chickadee-tech/pygb/README.md

# pygb
A Python powered GameBoy-compatible cartridge with a SAMD51

The PCB must be 0.8mm thick to fit in an existing game cart. Prototypes are done with OSH Park's 2 oz 0.8mm stackup.
