chickadee-tech/pygb/pygameboy.kicad_pcb

## KiCad design pygameboy.kicad_pcb (2019-03-31)

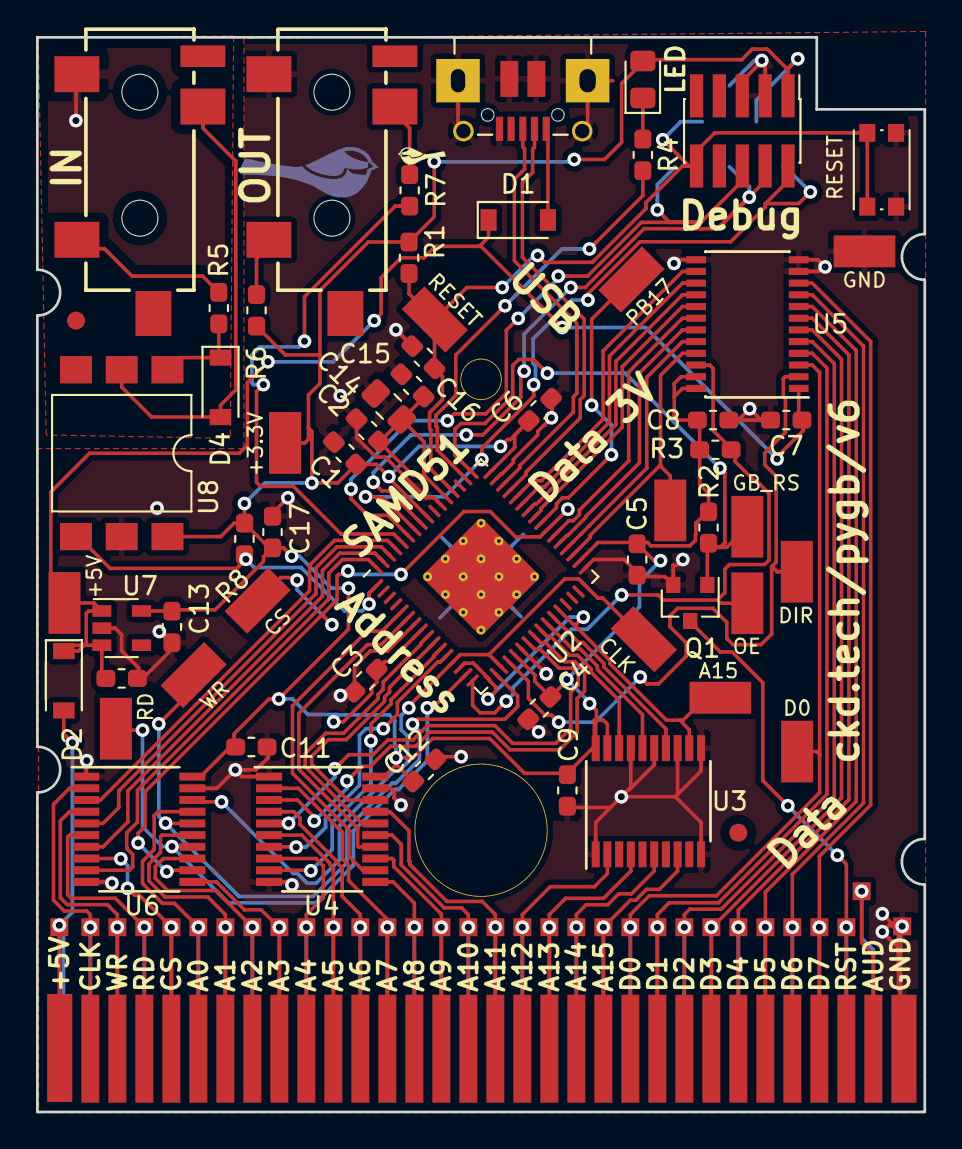
[picture p1: board pygameboy.kicad_pcb from above]

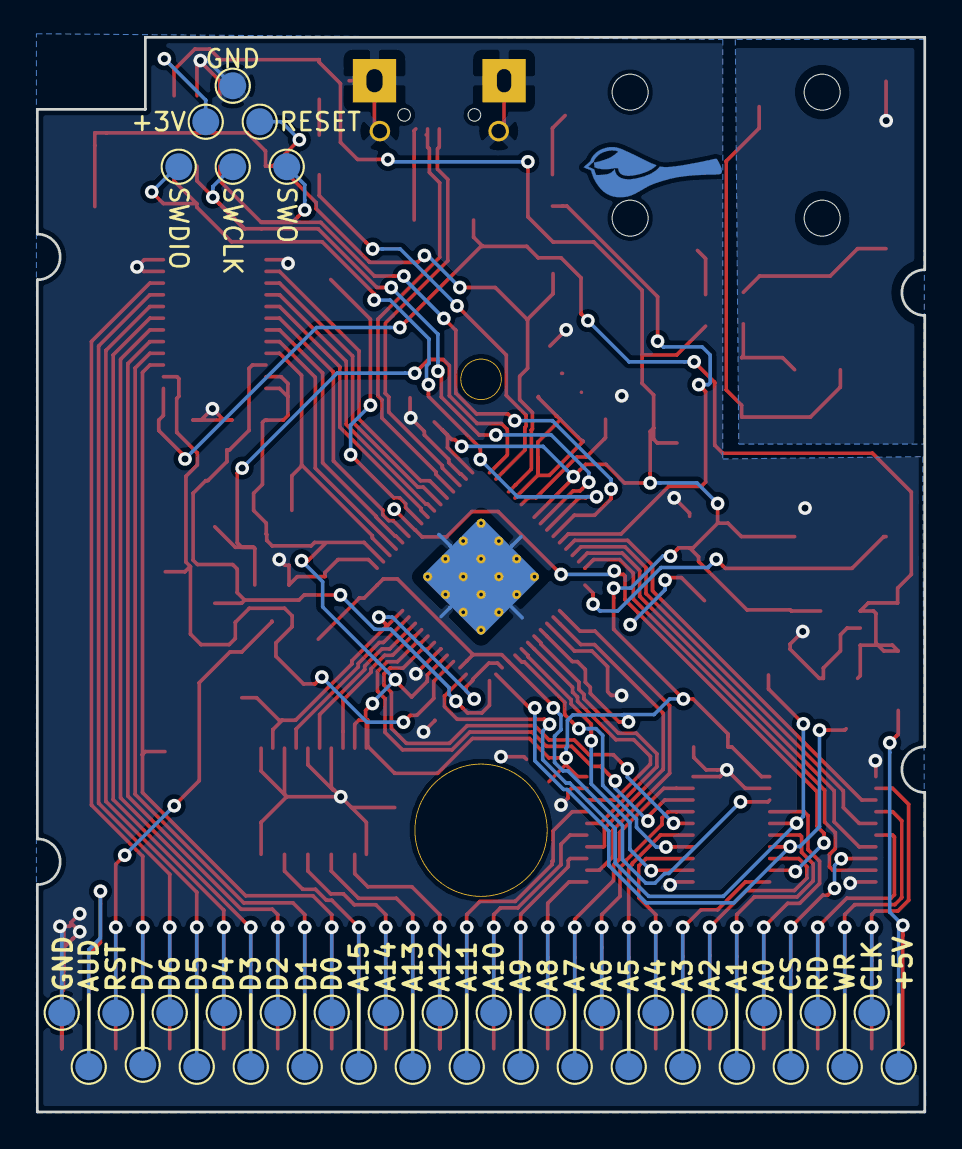
[picture p2: board pygameboy.kicad_pcb from below]

Board: 2 copper layers, 49.3 x 59.7 mm, 132 parts (38 on the bottom side), 83 nets.

Parts:
C1, C2, C3, C4, C5, C6, C7, C8, C9, C11, C12: 0.1uF; C_0603_1608Metric_Pad1.05x0.95mm_HandSolder
C10, C13, C15: 1uF; C_0603_1608Metric_Pad1.05x0.95mm_HandSolder
C14: 10uF; C_0805_2012Metric_Pad1.15x1.40mm_HandSolder
C16, C17: C_Small; C_0603_1608Metric_Pad1.05x0.95mm_HandSolder
D1, D2: MBR120; D_SOD-123
D3: LED; LED_0805_2012Metric_Pad1.15x1.40mm_HandSolder
D4: 1N4148W; D_SOD-123
FID0, FID1: TestPoint; Fiducial_1mm_Mask2mm
J1: Conn_01x01; Small Hole
J2: Conn_01x01; Large Hole
J3: Conn_ARM_JTAG_SWD_10; Pin_Header_Straight_2x05_Pitch1.27mm_SMD
J4: USB_B_Micro; 4UCONN_20329_V2_USB
J5: MIDI IN; 4UCONN_19269_TRS
J6: MIDI OUT; 4UCONN_19269_TRS
Q1: BSS138; SOT-23
R1, R2, R3: 10k; R_0603_1608Metric_Pad1.05x0.95mm_HandSolder
R4: 1k; R_0603_1608Metric_Pad1.05x0.95mm_HandSolder
R5: 220; R_0603_1608Metric_Pad1.05x0.95mm_HandSolder
R6, R7: 51; R_0603_1608Metric_Pad1.05x0.95mm_HandSolder
R8: 470; R_0603_1608Metric_Pad1.05x0.95mm_HandSolder
SW1: SW_Push; SW_SPST_KMR2
TP1, TP2, TP3, TP4, TP5, TP6, TP7, TP8, TP9, TP10, TP11, TP12, TP13, TP14, TP15, TP16, TP17, TP18, TP19, TP20, TP21, TP22, TP23, TP24, TP25, TP26, TP27, TP28, TP29, TP30, TP31, TP32: Test_Point; Test Point
TP33: Test_Point; 5015-SMT-TestPoint-NoPaste
TP34: DATA_OE; 5015-SMT-TestPoint-NoPaste
TP35: GB_RESET; 5015-SMT-TestPoint-NoPaste
TP36: SAMD_RESET; 5015-SMT-TestPoint-NoPaste
TP37: gnd; 5015-SMT-TestPoint-NoPaste
TP38: 3.3v; 5015-SMT-TestPoint-NoPaste
TP39: batt; 5015-SMT-TestPoint-NoPaste
TP40: clk; 5015-SMT-TestPoint-NoPaste
TP41: rd; 5015-SMT-TestPoint-NoPaste
TP42: wr; 5015-SMT-TestPoint-NoPaste
TP43: a15; 5015-SMT-TestPoint-NoPaste
TP44: PB17; 5015-SMT-TestPoint-NoPaste
TP45: cs; 5015-SMT-TestPoint-NoPaste
TP46: data0; 5015-SMT-TestPoint-NoPaste
TP47: D0; 5015-SMT-TestPoint-NoPaste
TP48, TP49, TP50, TP51, TP52, TP53, TP54, TP55, TP56, TP57, TP58, TP59, TP60, TP61, TP62, TP63, TP64, TP65, TP66, TP67, TP68, TP69, TP70, TP71, TP72, TP73, TP74, TP75, TP76, TP77, TP78, TP79, TP80, TP81, TP82, TP83, TP84, TP85: Test_Point; TestPoint_Pad_D1.5mm
U1: CARTRIDGE; Cartridge
U2: SAMD51J; QFN-64-1EP_9x9mm_P0.5mm_EP4.7x4.7mm_ThermalVias
U3, U4, U6: 74LVC244; TSSOP-20_4.4x6.5mm_P0.65mm
U5: 74x4245; TSSOP-24_4.4x7.8mm_P0.65mm
U7: AP2204K-3.3; SOT-23-5
U8: H11L1; SMDIP-6_W9.53mm

Connections:
+3V3: C1.2, C3.2, C4.2, C5.2, C6.2, C8.1, C9.1, C11.1, C12.1, C13.2, C17.1, D3.2, J3.1, R1.1, R2.1, R3.1, R6.1, R8.1, TP38.1, TP84.1, U2.8, U2.21, U2.34, U2.48, U2.56, U3.19, U3.20, U4.20, U5.23, U5.24, U6.20, U7.5, U8.6
+5V: C7.1, C10.2, D1.1, D2.1, TP39.1, U5.1, U7.1, U7.3
+BATT: D2.2, TP1.1, TP48.1, U1.1
/3V_A0: U2.61, U6.3
/3V_A1: U2.62, U6.5
/3V_A2: U2.63, U6.7
/3V_A3: U2.64, U6.9
/3V_A4: U2.5, U4.12
/3V_A5: U2.6, U4.14
/3V_A6: U2.9, U4.16
/3V_A7: U2.10, U4.18
/3V_A8: U2.11, U4.9
/3V_A9: U2.12, U4.7
/3V_A10: U2.23, U4.5
/3V_A11: U2.24, U4.3
/3V_A12: U2.25, U3.18
/3V_A13: U2.26, U3.16
/3V_A14: U2.27, U3.14
/3V_A15: TP43.1, U2.14, U2.17, U2.28, U3.12
/3V_CLK: TP40.1, U2.13, U2.19, U2.32, U6.18
/3V_CS: TP45.1, U2.39, U6.12
/3V_D0: TP46.1, U2.35, U5.21
/3V_D1: U2.36, U5.20
/3V_D2: U2.37, U5.19
/3V_D3: U2.38, U5.18
/3V_D4: U2.41, U5.17
/3V_D5: U2.42, U5.16
/3V_D6: U2.43, U5.15
/3V_D7: U2.44, U5.14
/3V_RD: TP41.1, U2.15, U6.14
/3V_WR: TP42.1, U2.18, U6.16
/A0: TP6.1, TP53.1, U1.6, U6.17
/A1: TP7.1, TP54.1, U1.7, U6.15
/A2: TP8.1, TP55.1, U1.8, U6.13
/A3: TP9.1, TP56.1, U1.9, U6.11
/A4: TP10.1, TP57.1, U1.10, U4.8
/A5: TP11.1, TP58.1, U1.11, U4.6
/A6: TP12.1, TP59.1, U1.12, U4.4
/A7: TP13.1, TP60.1, U1.13, U4.2
/A8: TP14.1, TP61.1, U1.14, U4.11
/A9: TP15.1, TP62.1, U1.15, U4.13
/A10: TP16.1, TP63.1, U1.16, U4.15
/A11: TP17.1, TP64.1, U1.17, U4.17
/A12: TP18.1, TP65.1, U1.18, U3.2
/A13: TP19.1, TP66.1, U1.19, U3.4
/A14: TP20.1, TP67.1, U1.20, U3.6
/A15: TP21.1, TP68.1, U1.21, U3.8
/AUD: TP31.1, TP78.1, U1.31
/CLK: TP2.1, TP49.1, U1.2, U6.2
/CS: TP5.1, TP52.1, U1.5, U6.8
/D0: TP22.1, TP47.1, TP69.1, U1.22, U5.3
/D1: TP23.1, TP70.1, U1.23, U5.4
/D2: TP24.1, TP71.1, U1.24, U5.5
/D3: TP25.1, TP72.1, U1.25, U5.6
/D4: TP26.1, TP73.1, U1.26, U5.7
/D5: TP27.1, TP74.1, U1.27, U5.8
/D6: TP28.1, TP75.1, U1.28, U5.9
/D7: TP29.1, TP76.1, U1.29, U5.10
/DATA_OE: R3.2, TP34.1, U2.16, U5.22
/DIR: TP33.1, U2.20, U5.2
/GB_RESET: Q1.1, R2.2, TP35.1, U2.49
/LED: R4.2, U2.50
/MIDI_IN: R8.2, U2.1, U8.4
/MIDI_OUT: R7.1, U2.60
/RD: TP4.1, TP51.1, U1.4, U6.6
/RESET: Q1.3, TP30.1, TP77.1, U1.30
/SAMD_RESET: C16.1, J3.10, R1.2, SW1.1, TP36.1, TP80.1, U2.52
/SWCLK: J3.4, TP81.1, U2.57
/SWDIO: J3.2, TP82.1, U2.58
/SWO: J3.6, TP83.1, U2.59
/USB_D+: J4.3, U2.46
/USB_D-: J4.2, U2.45
/WR: TP3.1, TP50.1, U1.3, U6.4
GND: C1.1, C2.2, C3.1, C4.1, C5.1, C6.1, C7.2, C8.2, C9.2, C10.1, C11.2, C12.2, C13.1, C14.1, C15.1, C16.2, C17.2, J3.3, J3.5, J4.5, J4.6, J6.S, Q1.2, SW1.2, TP32.1, TP37.1, TP79.1, TP85.1, U1.32, U2.7, U2.22, U2.33, U2.47, U2.54, U2.65, U3.1, U3.10, U3.11, U3.13, U3.15, U3.17, U4.1, U4.10, U4.19, U5.11, U5.12, U5.13, U6.1, U6.10, U6.19, U7.2, U8.5
unnamed: C2.1, C14.2, C15.2, U2.53
unnamed: D3.1, R4.1
unnamed: D4.1, R5.1, U8.1
unnamed: D4.2, J5.R, U8.2
unnamed: J5.T, R5.2
unnamed: J6.R, R7.2
unnamed: J6.T, R6.2
unnamed: TP44.1, U2.40
VBUS: D1.2, J4.1
