chickadee-tech/pygb/(threads)

Thread 6 (2019-10-11):

Making a prototype.

chrisgervang, 2019-10-11:
Hey there! This is a very cool project. I've been interested in gameboy mods this year - rom hacks, pcb mods. I am interested in putting together a prototype of this! Do you have any tips / documentation?

I'm familiar with board bring ups and all the basic stuff.. more curious if there is anything you haven't documented yet that would be helpful.

tannewt, 2019-10-11:
Thanks! I don't have much but am happy to answer questions. The first thing is to get the PCB with 0.8mm rather than the normal 1.6mm. That way it'll fit in existing carts.
