chickadee-tech/pygb/(commit log)

2018-05-02 Initial rev to OSH Park
    [pygameboy-B.Cu.gbr, pygameboy-B.Mask.gbr, pygameboy-B.Paste.gbr, pygameboy-B.SilkS.gbr, pygameboy-Edge.Cuts.gbr, pygameboy-F.Cu.gbr, pygameboy-F.Mask.gbr, pygameboy-F.Paste.gbr]
2018-06-11 v2 with added caps. reworked CCL signals and lotsa test points
    [pygameboy-B.Cu.gbr, pygameboy-B.Mask.gbr, pygameboy-B.Paste.gbr, pygameboy-B.SilkS.gbr, pygameboy-Edge.Cuts.gbr, pygameboy-F.Cu.gbr, pygameboy-F.Mask.gbr, pygameboy-F.Paste.gbr]
2019-03-09 Version 3
    [pygameboy-B.Cu.gbr, pygameboy-B.Mask.gbr, pygameboy-B.Paste.gbr, pygameboy-B.SilkS.gbr, pygameboy-Edge.Cuts.gbr, pygameboy-F.Cu.gbr, pygameboy-F.Mask.gbr, pygameboy-F.Paste.gbr]
2019-03-09 Fixup MIDI and switch to Adafruit parts
    [pygameboy.kicad_pcb, pygameboy.sch]
2019-03-10 More work on v5
    [pygameboy.kicad_pcb, pygameboy.sch]
2019-03-11 Final v5 version
    [pygameboy.kicad_pcb, pygameboy.sch]
2019-03-11 v5 gerbers used for stencil
    [pygameboy-B.Cu.gbr, pygameboy-B.Mask.gbr, pygameboy-B.Paste.gbr, pygameboy-B.SilkS.gbr, pygameboy-Edge.Cuts.gbr, pygameboy-F.Cu.gbr, pygameboy-F.Mask.gbr, pygameboy-F.Paste.gbr]
2019-03-31 Correct optoistolator footprint. Tweak spacing.
    [pygameboy.kicad_pcb, pygameboy.sch]
2019-08-05 Add Bill of Materials
    [PyGB - BOM.csv]
2020-08-19 Update for kicad 5.1.6 and use submodule for kicad-libs
    [pygameboy.sch]
